fornellas/3d_printed_keyboard/README.md

# 3D Printed Keyboard

For detailed documentation about this project, please visit:

https://fornellas.github.io/3d_printed_keyboard/
