fornellas/3d_printed_keyboard/STL/Left Frame.stl

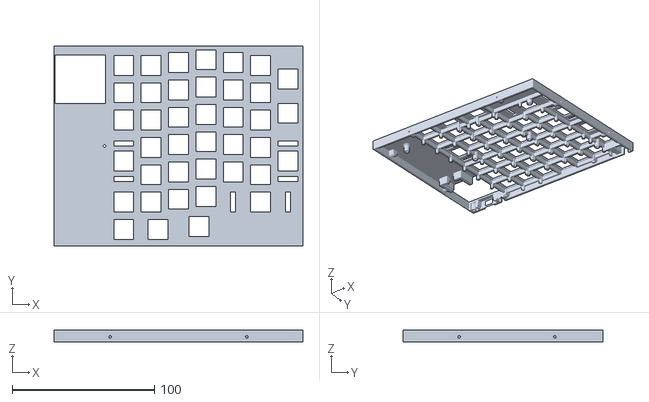
[picture p18: CAD file, 2017-12-26]
STL/Left Frame.stl
174.8 x 140.4 x 8.10
