fornellas/3d_printed_keyboard/STL/Keycap 1.5x1 Left Alt.stl

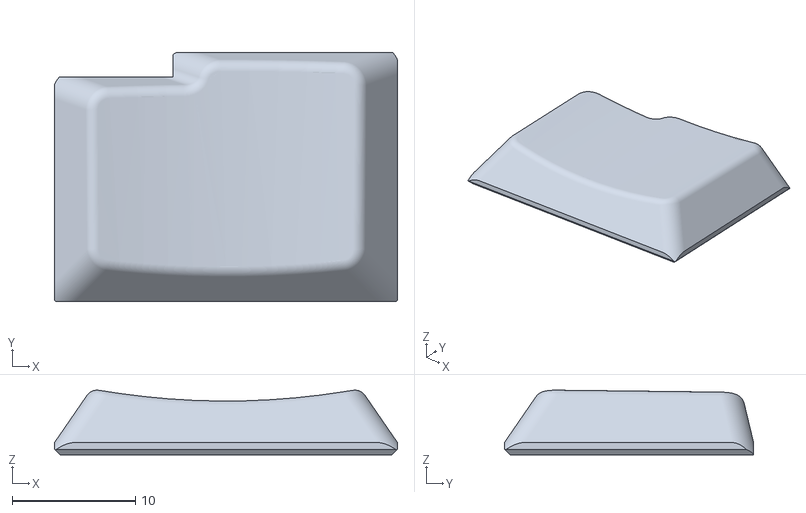
[picture p19: CAD file, 2017-12-26]
STL/Keycap 1.5x1 Left Alt.stl
27.8 x 20.2 x 5.24
