fornellas/3d_printed_keyboard/STL/Left Top Cover.stl

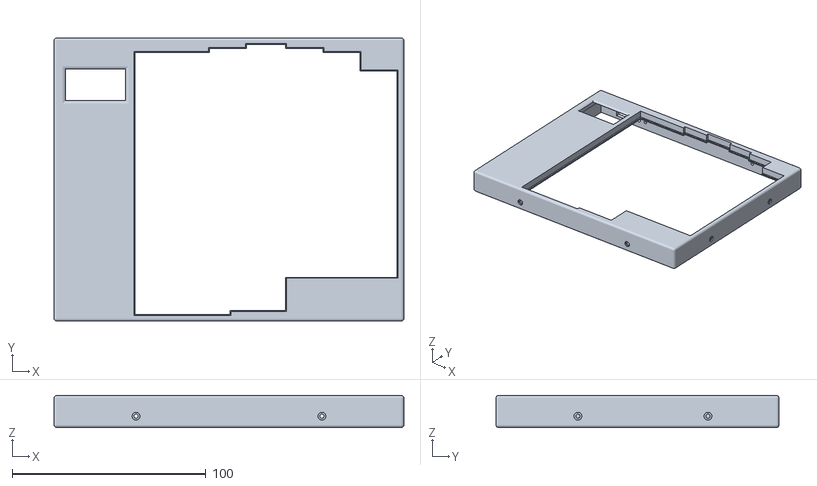
[picture p20: CAD file, 2017-12-26]
STL/Left Top Cover.stl
180.8 x 146.4 x 16.6
