fornellas/3d_printed_keyboard/STL/Left Bottom Cover.stl

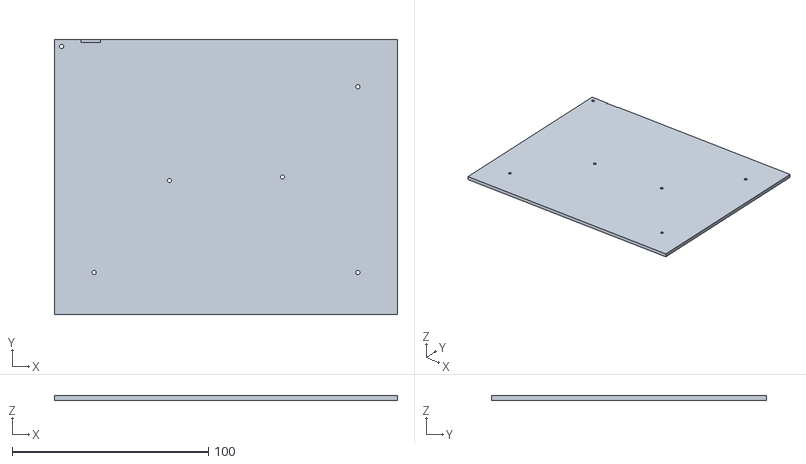
[picture p21: CAD file, 2017-12-26]
STL/Left Bottom Cover.stl
174.8 x 140.4 x 2.40
