fornellas/3d_printed_keyboard/STL/Right Bottom Cover.stl

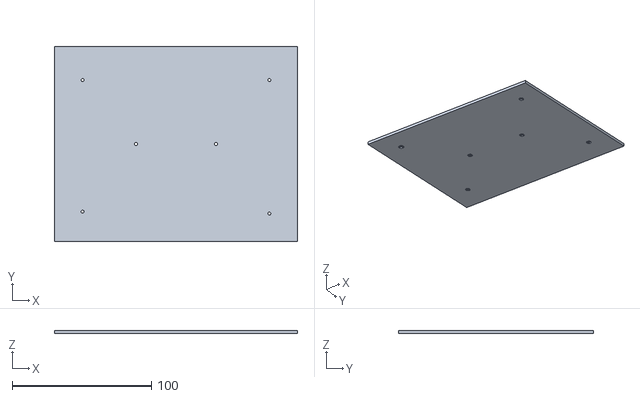
[picture p22: CAD file, 2017-12-26]
STL/Right Bottom Cover.stl
174.8 x 140.4 x 2.50
