fornellas/3d_printed_keyboard/STL/Keycap 1x1.stl

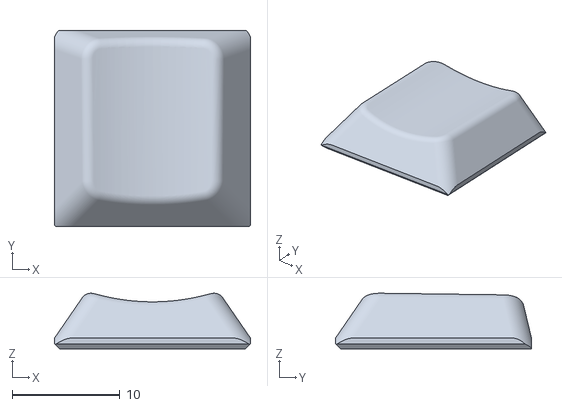
[picture p23: CAD file, 2017-12-26]
STL/Keycap 1x1.stl
18.2 x 18.2 x 5.16
