fornellas/3d_printed_keyboard/STL/Keycap 1x1.5.stl

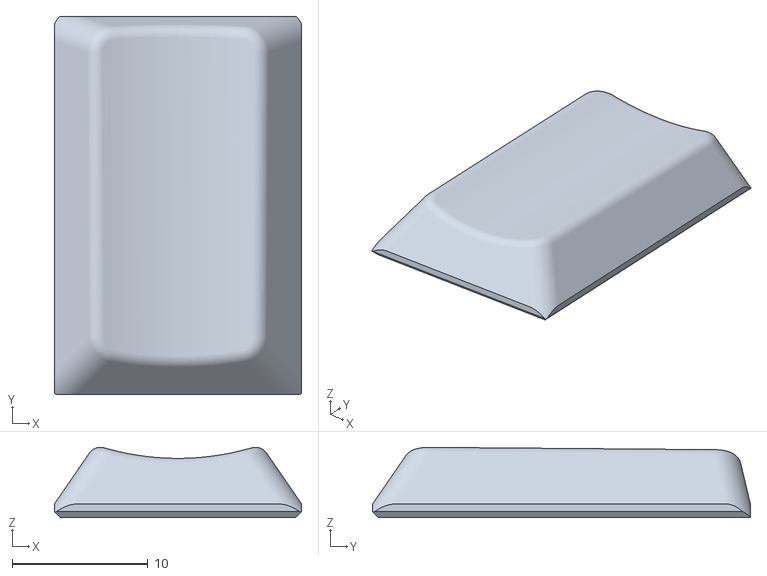
[picture p25: CAD file, 2017-12-26]
STL/Keycap 1x1.5.stl
18.2 x 27.8 x 5.17
