fornellas/3d_printed_keyboard/STL/Keycap 1x2 Left Bump.stl

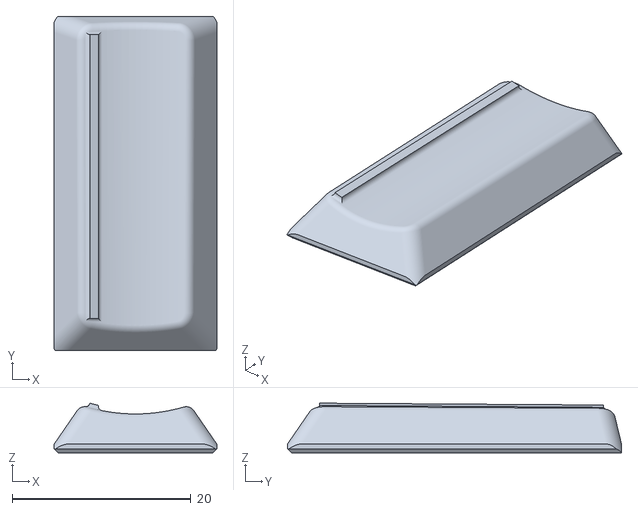
[picture p26: CAD file, 2017-12-26]
STL/Keycap 1x2 Left Bump.stl
18.2 x 37.4 x 5.57
