fornellas/3d_printed_keyboard/STL/Keycap 1.5x1 Start.stl

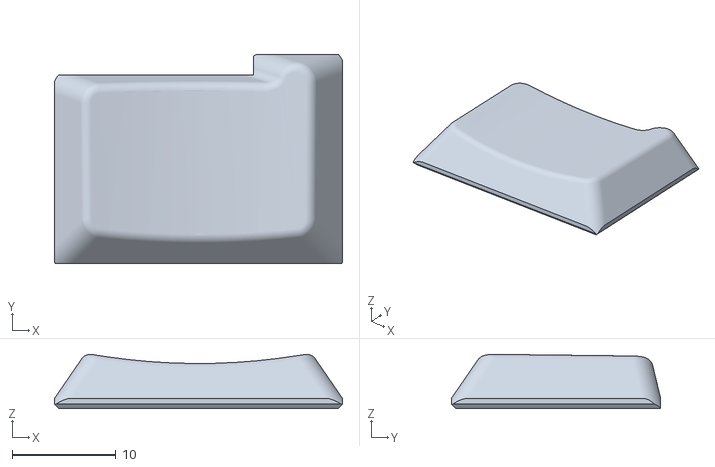
[picture p28: CAD file, 2017-12-26]
STL/Keycap 1.5x1 Start.stl
27.8 x 20.2 x 5.24
