fornellas/3d_printed_keyboard/STL/OLED Spacer.stl

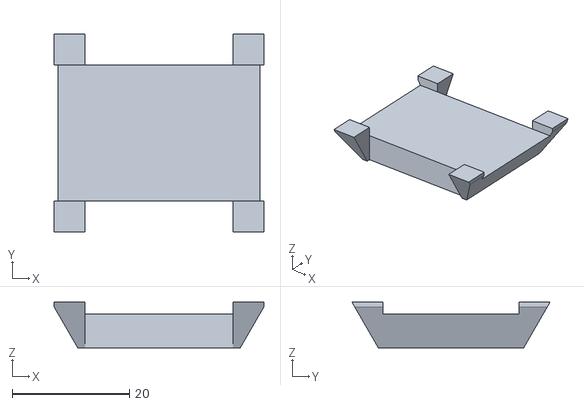
[picture p29: CAD file, 2017-12-26]
STL/OLED Spacer.stl
35.8 x 33.8 x 7.80
