fornellas/3d_printed_keyboard/STL/Keycap Right Spacebar.stl

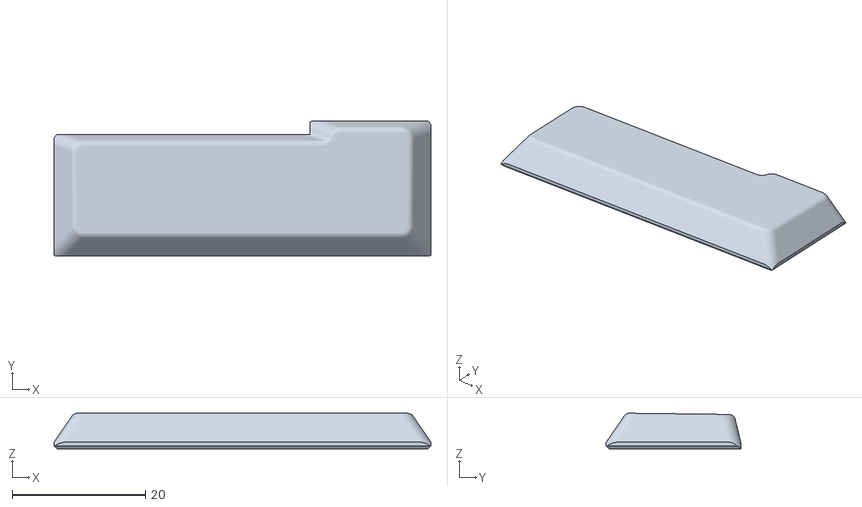
[picture p30: CAD file, 2017-12-26]
STL/Keycap Right Spacebar.stl
56.6 x 20.2 x 5.35
