fornellas/3d_printed_keyboard/STL/Right Top Cover.stl

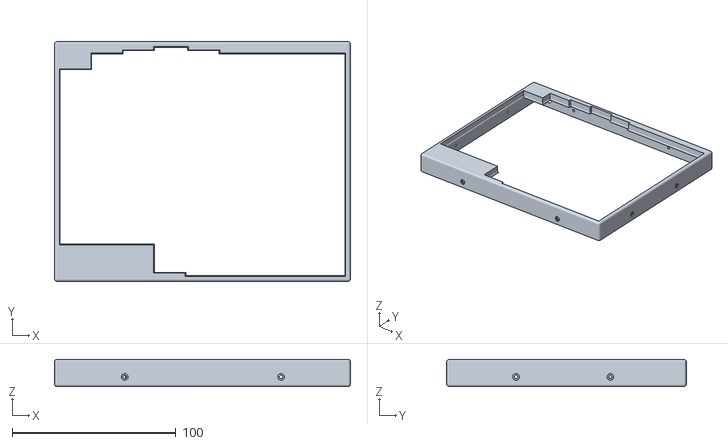
[picture p31: CAD file, 2017-12-26]
STL/Right Top Cover.stl
180.8 x 146.4 x 16.6
