fornellas/3d_printed_keyboard/STL/Stabilizer Keycap.stl

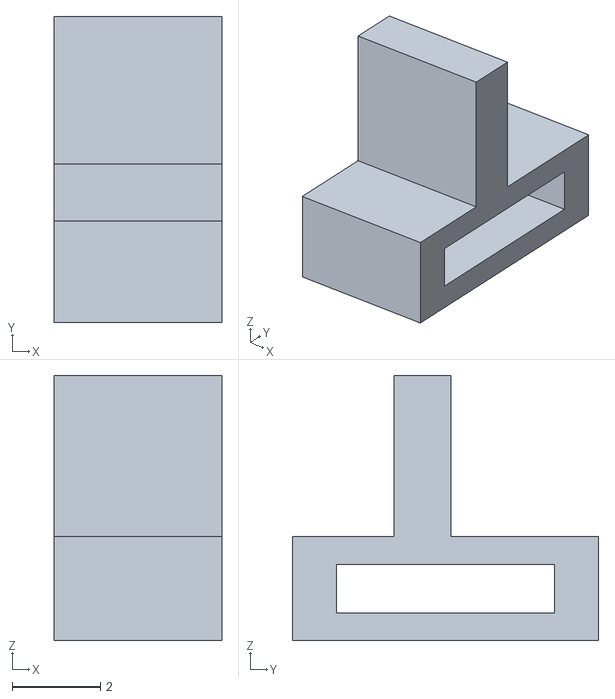
[picture p32: CAD file, 2017-12-26]
STL/Stabilizer Keycap.stl
3.81 x 6.95 x 6.02
