fornellas/3d_printed_keyboard/STL/Keycap Right Alt - Home.stl

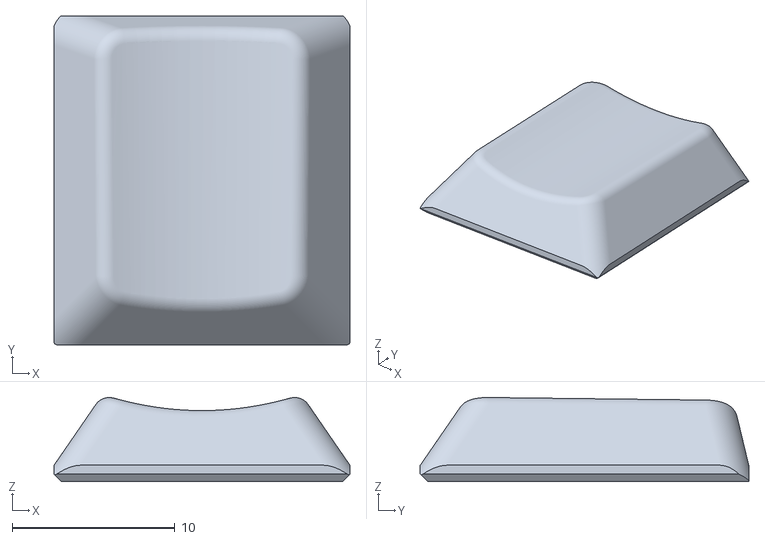
[picture p33: CAD file, 2017-12-26]
STL/Keycap Right Alt - Home.stl
18.2 x 20.2 x 5.17
