fornellas/3d_printed_keyboard/STL/Palm Rest.stl

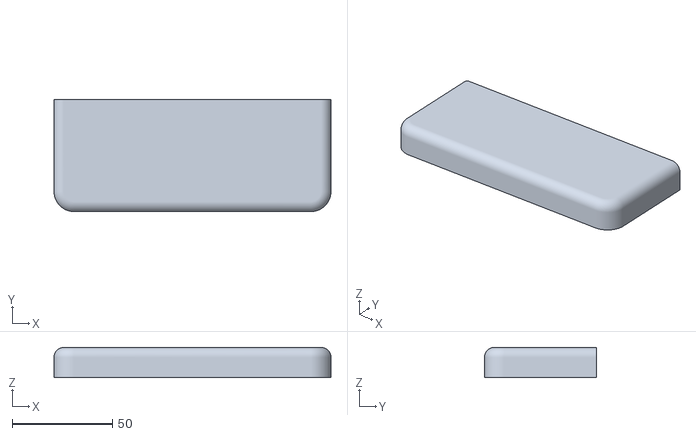
[picture p34: CAD file, 2017-12-26]
STL/Palm Rest.stl
138.4 x 56.0 x 15.1
