fornellas/3d_printed_keyboard/STL/Stabilizer Frame.stl

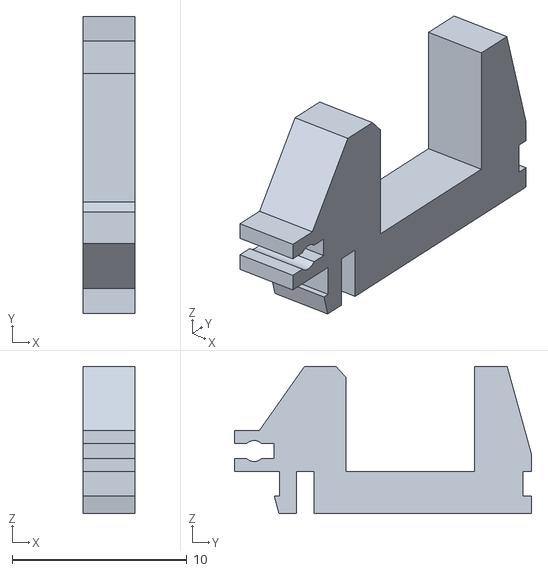
[picture p35: CAD file, 2017-12-26]
STL/Stabilizer Frame.stl
3.00 x 17.0 x 8.42
