fornellas/3d_printed_keyboard/(list of files, cad)

Other CAD files:
STL/Keycap 1x1 Left Bump.stl
STL/Keycap Left Spacebar.stl
STL/Keycap 1x1 Center Bump.stl
STL/Right Frame.stl
STL/Keycap 1x2 Right Bump.stl
