fornellas/3d_printed_keyboard/Keyboard.c

/*
             LUFA Library
     Copyright (C) Dean Camera, 2017.

  dean [at] fourwalledcubicle [dot] com
           www.lufa-lib.org
*/

/*
  Copyright 2017  Dean Camera (dean [at] fourwalledcubicle [dot] com)

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
  The author disclaims all warranties with regard to this
  software, including all implied warranties of merchantability
  and fitness.  In no event shall the author be liable for any
  special, indirect or consequential damages or any damages
  whatsoever resulting from loss of use, data or profits, whether
  in an action of contract, negligence or other tortious action,
  arising out of or in connection with the use or performance of
  this software.
*/

/** \file
 *
 *  Main source file for the Keyboard demo. This file contains the main tasks of
 *  the demo and is responsible for the initial application hardware configuration.
 */

#include "Counter.h"
#include "Keyboard.h"
#include "KeyboardReport.h"
#include "Keymap.h"
#include "LayerState.h"
#include "Sequence.h"
#include "Timer.h"
#ifdef SERIAL_DEBUG
#include <avr/io.h>
#endif

/** Buffer to hold the previously generated Keyboard HID report, for comparison purposes inside the HID class driver. */
static uint8_t PrevKeyboardHIDReportBuffer[sizeof(USB_ExtendedKeyboardReport_Data_t)];

/** LUFA HID Class driver interface configuration and state information. This structure is
 *  passed to all HID Class driver functions, so that multiple instances of the same class
 *  within a device can be differentiated from one another.
 */
USB_ClassInfo_HID_Device_t Keyboard_HID_Interface =
  {
    .Config =
      {
        .InterfaceNumber              = INTERFACE_ID_Keyboard,
        .ReportINEndpoint             =
          {
            .Address              = KEYBOARD_EPADDR,
            .Size                 = KEYBOARD_EPSIZE,
            .Banks                = 1,
          },
        .PrevReportINBuffer           = PrevKeyboardHIDReportBuffer,
        .PrevReportINBufferSize       = sizeof(PrevKeyboardHIDReportBuffer),
      },
  };

#ifdef SERIAL_DEBUG
/** LUFA CDC Class driver interface configuration and state information. This structure is
 *  passed to all CDC Class driver functions, so that multiple instances of the same class
 *  within a device can be differentiated from one another.
 */
USB_ClassInfo_CDC_Device_t VirtualSerial_CDC_Interface = {
   .Config = {
       .ControlInterfaceNumber   = INTERFACE_ID_CDC_CCI,
       .DataINEndpoint           = {
           .Address          = CDC_TX_EPADDR,
           .Size             = CDC_TXRX_EPSIZE,
           .Banks            = 1,
         },
       .DataOUTEndpoint = {
           .Address          = CDC_RX_EPADDR,
           .Size             = CDC_TXRX_EPSIZE,
           .Banks            = 1,
         },
       .NotificationEndpoint = {
           .Address          = CDC_NOTIFICATION_EPADDR,
           .Size             = CDC_NOTIFICATION_EPSIZE,
           .Banks            = 1,
         },
     },
  };
#endif

void Device_AnyKeyScanKeysCallback(struct Key key, void *data)
{
  uint8_t *any_key = (uint8_t *)data;

  if(key.state)
    *any_key = 1;
}

void Device_UnconfiguredScanKeys(void)
{
  uint8_t any_key = 0;

  if(!(DEVICE_STATE_Suspended == USB_DeviceState))
    return;

  ScanKeys_Read(&Device_AnyKeyScanKeysCallback, (void *)&any_key);

  if(any_key) {
    Display_Tick();
    if(USB_Device_RemoteWakeupEnabled)
      USB_Device_SendRemoteWakeup();
  }
}

  #ifdef SERIAL_DEBUG
/** Standard file stream for the CDC interface when set up, so that the virtual CDC COM port can be
 *  used like any regular character stream in the C APIs.
 */
FILE USBSerialStream;
  #endif

/** Main program entry point. This routine contains the overall program flow, including initial
 *  setup of all components and the main program loop.
 */
int main(void)
{

  SetupHardware();

  #ifdef SERIAL_DEBUG
  /* Create a regular character stream for the interface so that it can be used with the stdio.h functions */
  CDC_Device_CreateStream(&VirtualSerial_CDC_Interface, &USBSerialStream);
  #endif

  GlobalInterruptEnable();

  for (;;)
  {
    #ifdef SERIAL_DEBUG
    /* Must throw away unused bytes from the host, or it will lock up while waiting for the device */
    while(CDC_Device_ReceiveByte(&VirtualSerial_CDC_Interface) >= 0);
    CDC_Device_USBTask(&VirtualSerial_CDC_Interface);
    #endif
    HID_Device_USBTask(&Keyboard_HID_Interface);
    Display_Update();
    Device_UnconfiguredScanKeys();
  }
}

/** Configures the board hardware and chip peripherals for the demo's functionality. */
void SetupHardware()
{
  #if (ARCH == ARCH_AVR8)
  /* Disable watchdog if enabled by bootloader/fuses */
  MCUSR &= ~(1 << WDRF);
  wdt_disable();

  /* Disable clock division */
  clock_prescale_set(clock_div_1);
  #elif (ARCH == ARCH_XMEGA)
  /* Start the PLL to multiply the 2MHz RC oscillator to 32MHz and switch the CPU core to run from it */
  XMEGACLK_StartPLL(CLOCK_SRC_INT_RC2MHZ, 2000000, F_CPU);
  XMEGACLK_SetCPUClockSource(CLOCK_SRC_PLL);

  /* Start the 32MHz internal RC oscillator and start the DFLL to increase it to 48MHz using the USB SOF as a reference */
  XMEGACLK_StartInternalOscillator(CLOCK_SRC_INT_RC32MHZ);
  XMEGACLK_StartDFLL(CLOCK_SRC_INT_RC32MHZ, DFLL_REF_INT_USBSOF, F_USB);

  PMIC.CTRL = PMIC_LOLVLEN_bm | PMIC_MEDLVLEN_bm | PMIC_HILVLEN_bm;
  #endif

  /* Hardware Initialization */
  Timer_Init();
  Display_Init();
  ScanKeys_Init();
  Keymap_Init();
  LayerState_Init();
  Sequence_Init();
  Counter_Init();
  USB_Init();
}

/** Event handler for the library USB Connection event. */
void EVENT_USB_Device_Connect(void)
{
  Keymap_Init();
}

/** Event handler for the library USB Disconnection event. */
void EVENT_USB_Device_Disconnect(void)
{
  Display_Set_LEDReport(NO_LED_REPORT);
  Counter_Reset();
}

/** Event handler for the library USB Configuration Changed event. */
void EVENT_USB_Device_ConfigurationChanged(void)
{
  bool ConfigSuccess = true;

  ConfigSuccess &= HID_Device_ConfigureEndpoints(&Keyboard_HID_Interface);

  USB_Device_EnableSOFEvents();

  // if(ConfigSuccess) {
  //
  // } else {
  //
  // }

  #ifdef SERIAL_DEBUG
  CDC_Device_ConfigureEndpoints(&VirtualSerial_CDC_Interface);
  #endif
}

/** Event handler for the library USB Control Request reception event. */
void EVENT_USB_Device_ControlRequest(void)
{
  HID_Device_ProcessControlRequest(&Keyboard_HID_Interface);
  #ifdef SERIAL_DEBUG
  CDC_Device_ProcessControlRequest(&VirtualSerial_CDC_Interface);
  #endif
}

/** Event handler for the USB device Start Of Frame event. */
void EVENT_USB_Device_StartOfFrame(void)
{
  HID_Device_MillisecondElapsed(&Keyboard_HID_Interface);
}

/** HID class driver callback function for the creation of HID reports to the host.
 *
 *  \param[in]     HIDInterfaceInfo  Pointer to the HID class interface configuration structure being referenced
 *  \param[in,out] ReportID    Report ID requested by the host if non-zero, otherwise callback should set to the generated report ID
 *  \param[in]     ReportType  Type of the report to create, either HID_REPORT_ITEM_In or HID_REPORT_ITEM_Feature
 *  \param[out]    ReportData  Pointer to a buffer where the created report should be stored
 *  \param[out]    ReportSize  Number of bytes written in the report (or zero if no report is to be sent)
 *
 *  \return Boolean \c true to force the sending of the report, \c false to let the library determine if it needs to be sent
 */
bool CALLBACK_HID_Device_CreateHIDReport(USB_ClassInfo_HID_Device_t* const HIDInterfaceInfo,
                                         uint8_t* const ReportID,
                                         const uint8_t ReportType,
                                         void* ReportData,
                                         uint16_t* const ReportSize)
{
  USB_ExtendedKeyboardReport_Data_t* KeyboardReport = (USB_ExtendedKeyboardReport_Data_t*)ReportData;

  memset(KeyboardReport, 0, sizeof(USB_ExtendedKeyboardReport_Data_t));

  ScanKeys_Read(&KeyboardReport_ScanKeys_Callback, (void *)KeyboardReport);

  Sequence_Play(KeyboardReport);

  Keymap_PostProcess_KeyboardReport(KeyboardReport);

  #ifdef SERIAL_DEBUG
  if(KeyboardReport->Modifier)
    printf_P(PSTR("Report Modifier: %d\r\n"), KeyboardReport->Modifier);
  if(KeyboardReport->Reserved)
    printf_P(PSTR("Report Reserved: %d\r\n"), KeyboardReport->Reserved);
  for(uint8_t k=0 ; k < MAX_KEYS ; k++){
    if(KeyboardReport->KeyboardKeyPad[k])
      printf_P(PSTR("Report KeyboardKeyPad[%d]: %d\r\n"), k, KeyboardReport->KeyboardKeyPad[k]);
    if(KeyboardReport->GenericDesktop[k])
      printf_P(PSTR("Report GenericDesktop[%d]: %d\r\n"), k, KeyboardReport->GenericDesktop[k]);
    if(KeyboardReport->Consumer[k])
      printf_P(PSTR("Report Consumer[%d]: %d\r\n"), k, KeyboardReport->Consumer[k]);
  }
  #endif

  *ReportSize = sizeof(USB_ExtendedKeyboardReport_Data_t);
  return false;
}

/** HID class driver callback function for the processing of HID reports from the host.
 *
 *  \param[in] HIDInterfaceInfo  Pointer to the HID class interface configuration structure being referenced
 *  \param[in] ReportID    Report ID of the received report from the host
 *  \param[in] ReportType  The type of report that the host has sent, either HID_REPORT_ITEM_Out or HID_REPORT_ITEM_Feature
 *  \param[in] ReportData  Pointer to a buffer where the received report has been stored
 *  \param[in] ReportSize  Size in bytes of the received HID report
 */
void CALLBACK_HID_Device_ProcessHIDReport(USB_ClassInfo_HID_Device_t* const HIDInterfaceInfo,
                                          const uint8_t ReportID,
                                          const uint8_t ReportType,
                                          const void* ReportData,
                                          const uint16_t ReportSize)
{
  Display_Set_LEDReport(*(uint8_t*)ReportData);
}
