fornellas/3d_printed_keyboard/Bitmaps.h

#ifndef _LOGO_H_
#define _LOGO_H_

#include <inttypes.h>
#include <u8g2.h>

#define bitmap_logo_width 128
#define bitmap_logo_height 44
static const unsigned char bitmap_logo_bits[] U8X8_PROGMEM = {
  0b00000000, 0b00000000, 0b00000000, 0b00000000, 0b00000000, 0b00000000, 0b00000000, 0b00000000, 0b00000000, 0b00000000, 0b00000000, 0b00000000, 0b00000000, 0b00000000, 0b00000000, 0b00000000,
  0b00000000, 0b11110000, 0b00000001, 0b00000000, 0b00000000, 0b00000000, 0b00000000, 0b00000000, 0b00000000, 0b00000000, 0b00000000, 0b00000000, 0b00000000, 0b10000000, 0b00011111, 0b00000000,
  0b00000000, 0b11111000, 0b00111111, 0b00000000, 0b00000000, 0b00000000, 0b00000000, 0b00000000, 0b00000000, 0b00000000, 0b00000000, 0b00000000, 0b00000000, 0b11111100, 0b00011001, 0b00000000,
  0b00000000, 0b11111000, 0b11111111, 0b00000111, 0b00000000, 0b00000000, 0b00000000, 0b00000000, 0b00000000, 0b00000000, 0b00000000, 0b00000000, 0b11100000, 0b11101111, 0b00011001, 0b00000000,
  0b00000000, 0b11111100, 0b11111111, 0b11111101, 0b00000001, 0b00000000, 0b00000000, 0b00000000, 0b00000000, 0b00000000, 0b00000000, 0b10000000, 0b10111111, 0b11100111, 0b00111101, 0b00000000,
  0b00000000, 0b11111100, 0b11111111, 0b10111100, 0b00111111, 0b00000000, 0b00000000, 0b00000000, 0b00000000, 0b00000000, 0b00000000, 0b11111100, 0b00011101, 0b11111111, 0b00111111, 0b00000000,
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
  0b11111101, 0b10011111,
  0b00000001, 0b10000000,
  0b11111101, 0b10000011,
  0b00000001, 0b10000000,
  0b11111101, 0b10111111,
  0b00000001, 0b10000000,
  0b11111111, 0b11111111,
  0b10000000, 0b00000001,
  0b10000000, 0b00000001,
  0b11000000, 0b00000011,
  0b11111000, 0b00011111,
};

#define bitmap_keyboard_width 16
#define bitmap_keyboard_height 13
static const unsigned char bitmap_keyboard_bits[] U8X8_PROGMEM = {
  0b00000000, 0b00010000,
  0b00000000, 0b00010000,
  0b00000000, 0b00010000,
  0b00000000, 0b00001111,
  0b10000000, 0b00000000,
  0b10000000, 0b00000000,
  0b11111111, 0b11111111,
  0b00000001, 0b10000000,
  0b01010101, 0b10010101,
  0b00000001, 0b10000000,
  0b10101001, 0b10101010,
  0b00000001, 0b10000000,
  0b11111111, 0b11111111,
};

#endif
