fornellas/3d_printed_keyboard/KeyboardReport.h

#ifndef _KEYBOARD_REPORT_H_
#define _KEYBOARD_REPORT_H_

#include "ScanKeys.h"
#include "Keyboard.h"
#include <LUFA/Drivers/USB/USB.h>

void KeyboardReport_ScanKeys_Callback(struct Key key, void *data);
void KeyboardReport_Add_KeyboardKeypad(USB_ExtendedKeyboardReport_Data_t* KeyboardReport, uint16_t KeyCode);

#endif
