fornellas/3d_printed_keyboard/(commit log)

2017-11-12 Add Teensy 2.0++ build/load rules
2017-11-17 Fix T key mapping
    [Keymap.h]
2017-11-18 Add more missing keys
    [Keymap.c, Keymap.h]
2017-11-18 Add cut/copy/paste sequences
2017-11-19 Display USB Device State
2017-11-19 Fix sequence buffer size
    [Sequence.c]
2017-11-20 Increase current to 500ma
2017-11-20 Add LED display
2017-11-21 Fix current to actual 100mA
    [Descriptors.c]
2017-11-22 Fix remote wake up
    [Descriptors.c]
2017-12-18 Move SPI setup to Display
2017-12-21 Double SPI speed
2017-12-21 Extract Timer
2017-12-22 Remove Timer_Millis
2017-12-23 Fix remote wake up for all keys.
    [Keyboard.c, Keyboard.h]
2017-12-24 Fix left lide scan
    [ScanKeys.c]
2017-12-24 Enable INTERRUPT_CONTROL_ENDPOINT
2017-12-26 Add STL files
    [Keycap 1.5x1 Left Alt.stl, Keycap 1.5x1 Start.stl, Keycap 1x1 Center Bump.stl, Keycap 1x1 Left Bump.stl, Keycap 1x1 Right Bump.stl, Keycap 1x1.5.stl, Keycap 1x1.stl, Keycap 1x2 Left Bump.stl]
2017-12-26 Fix video frame width
2018-01-02 Add missing volume keys
    [Keymap.c]
2018-04-15 Fix wrong context reference
    [Display.c]
2018-04-15 Fix missing tick when not remote wakeup enabled
    [Keyboard.c]
